Troy0408/Embedded-Course-Design/docs/嵌入式系统课程设计.md

# 2026嵌入式系统课程设计

## 时间安排

地点：理学馆210

### 集合与选题

时间：2026-06-29 9:00

- 宣布课程设计要求与考核标准
- 分组选题，确定题目（三选一），每组不超过3人

### 提交计划书

时间：2026-06-30 9:00

各组提交《项目计划书》（本阶段为小组任务，每组提交一份），内容包括：

- **工作计划**：从选题到验收的详细时间节点，明确各阶段里程碑
- **时间安排**：组内成员的可投入时间与分工协调计划
- **物料采购计划**：列出所需全部物料清单（型号、数量、单价、采购渠道），预估总成本
- **分工方案**：明确每位成员的具体职责（硬件设计、软件开发、测试调试、文档撰写等）

### 设计文档提交与汇报

时间：2026-07-02 9:00

各组提交《系统设计文档》并分组汇报（本阶段为小组任务，每组提交一份），内容包括：

- **物料到位情况**：已到货物料清单与实物核对情况，未到货物料的预计到位时间
- **系统方案设计**：系统总体架构、硬件框图、软件流程图
- **详细设计文档**：
  - 硬件部分：电路原理图、关键元件参数计算、PCB布局规划（如有）
  - 软件部分：模块划分、关键算法描述、外设配置方案、任务调度设计（FreeRTOS任务划分等）
- **进度汇报**：当前完成情况与后续工作计划

### 中期检查

时间：2026-07-06 15:00

- 物料完备性检查：核对所有物料是否到位
- 进度检查：硬件搭建情况、软件调试进度
- 问题排查：识别当前瓶颈，给出解决方案建议

各组提交《中期检查报告》（本阶段为小组任务，每组提交一份），内容包括：

- 物料到位总览：已到位、未到位的物料明细
- 当前完成进度：已完成工作、进行中工作、未开始工作
- 硬件调试情况：各模块测试结果、遇到的问题与解决措施
- 软件调试情况：各功能模块开发进度、已通过的测试用例
- 存在的问题与风险：技术难点、物料延期等风险及应对方案
- 后续工作计划：至验收前的详细计划与分工调整（如有）

### 第一次验收

时间：2026-07-09 9:00

- 分组演示系统功能，现场测试
- 教师提出问题与修改意见
- 提交阶段性成果（功能演示视频、测试数据记录）

### 第二次验收

时间：2026-07-10 9:00

- 根据第一次验收意见进行改进后再次验收
- 最终评定成绩

### 个人总结报告

提交截止：验收后一周内

每位同学独立提交个人总结报告（每人一份），使用 LaTeX 模板撰写（模板参见 `课程报告LaTex模板/`），报告应包含以下章节：

| 章节 | 内容要求 |
| ---- | ---- |
| 项目简介 | 项目背景、主要功能概述 |
| 项目设计目标 | 设计目标与预期成果 |
| 项目设计与实现 | 硬件设计（系统架构、模块选型、电路原理图）、软件设计（软件架构、主程序流程、关键代码、技术实现细节） |
| 功能展示 | 功能描述、演示结果、测试数据与截图 |
| 物料与成本 | 物料清单（名称、数量、单价、用途）、项目总成本、损耗与损坏记录 |
| 个人贡献 | 报告撰写分工、个人编码工作内容、硬件连接工作、资本投入、开发中遇到的问题及解决方案 |
| 项目成果与反思 | 成果展示、项目评估（成功之处与不足）、个人反思与改进方向 |
| 附录 | 设计图纸、完整代码清单、参考文献 |

#### 题目：基于STM32F103C8T6的智能手表设计

##### 介绍

智能手表项目是一个基于STM32F103C8T6的嵌入式系统，采用FreeRTOS实时操作系统实现多任务管理，集成OLED显示和陀螺仪姿态检测等功能。项目涵盖硬件电路设计、RTOS任务调度、I2C总线通信及低功耗电源管理，适合学习嵌入式系统综合开发。

##### 基本原理

**硬件架构**：采用STM32F103C8T6作为主控MCU，通过I2C总线连接OLED显示屏（1.3寸）及陀螺仪（MPU6050）。I2C总线只需SCL和SDA两根线即可实现多设备通信，布线简洁。时间基准利用SysTick定时器或通用定时器产生秒中断实现软件计时，无需额外RTC芯片。电源部分采用LDO低压差稳压芯片，通过Type-C接口为3.7V锂电池充电，并设计一键开机电路。

**FreeRTOS任务调度**：FreeRTOS是一个轻量级实时操作系统内核，支持抢占式和合作式两种任务调度方式。高优先级任务可抢占低优先级任务的CPU资源。任务状态包括运行态、就绪态、阻塞态和挂起态。系统的时钟节拍由SysTick滴答定时器提供，每次中断驱动OS的任务调度。

**任务间通信**：为防止多任务对共享资源的访问冲突，FreeRTOS提供信号量（二值信号量、计数信号量、互斥信号量）、消息队列和邮箱等通信机制，实现任务同步与数据传递。

**内存管理**：FreeRTOS提供多种内存分配策略，其中heap_4按物理地址排序管理空闲块，便于相邻空闲内存的合并，减少碎片。

##### 基本要求

- 完成智能手表硬件电路设计（MCU、OLED、陀螺仪、电源）
- 基于FreeRTOS实现多任务管理，完成时间显示与传感器数据读取
- 实现OLED界面显示，至少包含时间页面与传感器数据页面

##### 扩展要求

1. 增加旋转编码器，实现多级菜单的切换与选择
2. 增加蓝牙控制功能，实现与手机的数据同步，并设计蓝牙上位机
3. 完成PCB的设计，可使用最小系统板
4. 实现运动计步算法与运动数据记录功能

##### 考核要求

| 等级 | 评定标准 |
| ---- | ---- |
| 优秀 | 完成全部基本要求与扩展要求1、2，以及3或4（PCB设计与计步功能二选一）；PCB布局布线合理（选3时）；计步算法准确、数据记录完整（选4时）；FreeRTOS任务划分合理、无死锁；OLED多级菜单流畅，蓝牙同步稳定，上位机界面美观、功能完整；设计文档详实，答辩表述清晰。 |
| 良好 | 完成全部基本要求与扩展要求1、2；OLED多级菜单切换流畅；蓝牙同步与上位机功能正常；设计文档完整，答辩表述较清晰。 |
| 中等 | 完成全部基本要求与至少一项扩展要求；OLED可正常显示时间与传感器数据；设计文档基本完整，答辩能说明设计思路。 |
| 及格 | 完成基本要求；OLED可显示时间信息；设计文档包含关键内容，答辩能回答基本问题。 |

##### 设计步骤

1. **需求分析与方案设计**：明确智能手表的功能需求，确定硬件选型与软件架构，划分FreeRTOS任务。
2. **硬件电路设计**：设计STM32最小系统、OLED/MPU6050的I2C接口电路、LDO电源电路及一键开机电路。
3. **FreeRTOS移植与任务划分**：移植FreeRTOS到STM32F103C8T6，划分任务（UI显示任务、时间管理任务、传感器采集任务、蓝牙通信任务等），定义任务优先级与通信方式。
4. **外设驱动开发**：编写I2C驱动、OLED驱动、MPU6050驱动及软件计时模块（基于SysTick/定时器秒中断），完成数据读取与显示。
5. **系统集成与测试**：整合各模块，调试多任务运行，测试菜单切换、传感器数据更新、蓝牙通信等功能，分析并优化系统性能。

##### DEMO参考

参考DEMO所用器件：

| 器件 | 参数 |
| ---- | ---- |
| 主控芯片 | STM32F103C8T6 |
| 显示屏 | 1.3寸 OLED（I2C接口） |
| 陀螺仪 | MPU6050（I2C接口） |
| 电源芯片 | LDO低压差稳压芯片 |
| 电池 | 3.7V锂电池 |
| 供电接口 | Type-C |
