Troy0408/Embedded-Course-Design/SmartWatch_FreeRTOS/SmartWatch_FreeRTOS.ioc

Mcu.UserName=STM32F103C8Tx
PA13.Signal=SYS_JTMS-SWDIO
PA14.Signal=SYS_JTCK-SWCLK
PA2.Signal=USART2_TX
PA3.Signal=USART2_RX
PA6.GPIO_Label=ENCODER_A
PA6.Signal=GPIO_Input
PA7.GPIO_Label=ENCODER_B
PA7.Signal=GPIO_Input
PB1.GPIO_Label=BUTTON_OK
PB1.Signal=GPIO_Input
PB0.GPIO_Label=HC05_STATE
PB0.Signal=GPIO_Input
PB10.Signal=I2C2_SCL
PB11.Signal=I2C2_SDA
PB6.Signal=I2C1_SCL
PB7.Signal=I2C1_SDA
PD0-OSC_IN.Signal=RCC_OSC_IN
PD1-OSC_OUT.Signal=RCC_OSC_OUT
