Troy0408/Embedded-Course-Design/SmartWatch_FreeRTOS/Core/Src/main.c

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
/* Includes ------------------------------------------------------------------*/
#include "main.h"
#include "dma.h"
#include "i2c.h"
#include "usart.h"
#include "gpio.h"

/* USER CODE BEGIN Includes */
#include "oled.h"
#include "smartwatch_ui.h"
#include "mpu6050.h"
#include "usart.h"
#include "bluetooth.h"
#include "encoder.h"
#include "step_counter.h"
#include "app_freertos.h"
/* USER CODE END Includes */


/* USER CODE BEGIN PV */
SmartWatchData_t watch_data;
StepCounter_t step_counter;
/* USER CODE END PV */

void SystemClock_Config(void);
/* USER CODE BEGIN 0 */
static void UpdateMpuDiagnostics(SmartWatchData_t *data)
{
    data->mpu_ready_68 = MPU6050_IsReadyAt(0x68);
    data->mpu_ready_69 = MPU6050_IsReadyAt(0x69);
    data->mpu_whoami_68 = data->mpu_ready_68 ? MPU6050_ReadWhoAmIAt(0x68) : 0x00;
    data->mpu_whoami_69 = data->mpu_ready_69 ? MPU6050_ReadWhoAmIAt(0x69) : 0x00;
}

static void UpdateEncoderDiagnostics(SmartWatchData_t *data)
{
    EncoderDebug_t debug;
    Encoder_GetDebug(&debug);
    data->enc_a = debug.a;
    data->enc_b = debug.b;
    data->enc_cw = debug.cw_count;
    data->enc_ccw = debug.ccw_count;
    data->enc_press = debug.press_count;
    data->enc_transitions = debug.transition_count;
}

/* USER CODE END 0 */

/**
  * @brief  The application entry point.
  * @retval int
  */
int main(void)
{

  /* MCU Configuration--------------------------------------------------------*/

  /* Reset of all peripherals, Initializes the Flash interface and the Systick. */
  HAL_Init();

  /* Configure the system clock */
  SystemClock_Config();

  /* Initialize all configured peripherals */
  MX_GPIO_Init();
  MX_DMA_Init();
  MX_I2C1_Init();
  MX_I2C2_Init();
  MX_USART2_UART_Init();
  /* USER CODE BEGIN 2 */

  UI_InitData(&watch_data);

  /* Initialize OLED */
  OLED_Init();

  /* Initialize MPU6050 */
  UpdateMpuDiagnostics(&watch_data);
  watch_data.imu_status = (MPU6050_Init() == 0) ? 1 : 0;
  if (!watch_data.imu_status) {
      UpdateMpuDiagnostics(&watch_data);
  }

  /* Initialize Bluetooth */
  BT_Init();
  watch_data.bt_connected = 0;

  /* Initialize encoder and step counter */
  Encoder_Init();
  StepCounter_Init(&step_counter);
  UpdateEncoderDiagnostics(&watch_data);

  /* Show watch face first */
  watch_data.current_page = PAGE_WATCH_FACE;
  UI_DrawPage(watch_data.current_page, &watch_data);

  App_FreeRTOS_Start();

  /* USER CODE END 2 */

  /* Infinite loop */
  /* USER CODE BEGIN WHILE */
  while (1)
  {
    /* USER CODE END WHILE */

    /* USER CODE BEGIN 3 */
    HAL_Delay(1000);
  }
  /* USER CODE END 3 */
}

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
