Troy0408/Embedded-Course-Design/SmartWatch_FreeRTOS/Core/Inc/main.h

#define HC05_STATE_Pin GPIO_PIN_0
#define HC05_STATE_GPIO_Port GPIOB
#define BUTTON_OK_Pin GPIO_PIN_1
#define BUTTON_OK_GPIO_Port GPIOB
#define ENCODER_A_Pin GPIO_PIN_6
#define ENCODER_A_GPIO_Port GPIOA
#define ENCODER_B_Pin GPIO_PIN_7
#define ENCODER_B_GPIO_Port GPIOA
