Troy0408/Embedded-Course-Design/SmartWatch_FreeRTOS/Core/Src/oled.c

#include "oled.h"
#include "i2c.h"
#include <stdio.h>
#include <stdarg.h>
#include <string.h>

/* ==================== Framebuffer ==================== */
uint8_t OLED_Buffer[SSD1306_WIDTH * SSD1306_PAGES];

/* ==================== 6x8 Font (ASCII 0x20-0x7E, 95 chars, 6 bytes each) ==================== */
static const uint8_t Font6x8[96][6] = {
    {0x00,0x00,0x00,0x00,0x00,0x00}, /*   space */
    {0x00,0x00,0x5F,0x00,0x00,0x00}, /* ! */
    {0x00,0x07,0x00,0x07,0x00,0x00}, /* " */
    {0x14,0x7F,0x14,0x7F,0x14,0x00}, /* # */
    {0x24,0x2A,0x7F,0x2A,0x12,0x00}, /* $ */
    {0x23,0x13,0x08,0x64,0x62,0x00}, /* % */
    {0x36,0x49,0x55,0x22,0x50,0x00}, /* & */
    {0x00,0x05,0x03,0x00,0x00,0x00}, /* ' */
    {0x00,0x1C,0x22,0x41,0x00,0x00}, /* ( */
    {0x00,0x41,0x22,0x1C,0x00,0x00}, /* ) */
    {0x08,0x2A,0x1C,0x2A,0x08,0x00}, /* * */
    {0x08,0x08,0x3E,0x08,0x08,0x00}, /* + */
    {0x00,0x50,0x30,0x00,0x00,0x00}, /* , */
    {0x08,0x08,0x08,0x08,0x08,0x00}, /* - */
    {0x00,0x60,0x60,0x00,0x00,0x00}, /* . */
    {0x20,0x10,0x08,0x04,0x02,0x00}, /* / */
    {0x3E,0x51,0x49,0x45,0x3E,0x00}, /* 0 */
    {0x00,0x42,0x7F,0x40,0x00,0x00}, /* 1 */
    {0x42,0x61,0x51,0x49,0x46,0x00}, /* 2 */
    {0x21,0x41,0x45,0x4B,0x31,0x00}, /* 3 */
    {0x18,0x14,0x12,0x7F,0x10,0x00}, /* 4 */
    {0x27,0x45,0x45,0x45,0x39,0x00}, /* 5 */
    {0x3C,0x4A,0x49,0x49,0x30,0x00}, /* 6 */
    {0x01,0x71,0x09,0x05,0x03,0x00}, /* 7 */
    {0x36,0x49,0x49,0x49,0x36,0x00}, /* 8 */
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
     0x00,0x00,0x00,0x01,0x01,0x01,0x01,0x81,0xC1,0x61,0x3F,0x1F,0x00,0x00,0x00,0x00,
     0x00,0x00,0x00,0x20,0x61,0x63,0x63,0x63,0x63,0x32,0x1E,0x0F,0x00,0x00,0x00,0x00},
    /* : */
    {0x00,0x00,0x00,0x00,0x00,0x30,0x30,0x00,0x00,0x00,0x00,0x00,0x00,0x00,0x00,0x00,
     0x00,0x00,0x00,0x00,0x00,0x18,0x18,0x00,0x00,0x00,0x00,0x00,0x00,0x00,0x00,0x00,
     0x00,0x00,0x00,0x00,0x00,0x0C,0x0C,0x00,0x00,0x00,0x00,0x00,0x00,0x00,0x00,0x00},
};

/* ==================== Icon bitmaps ==================== */
/* Heart icon 10x10 */
const uint8_t IconHeart[20] = {
    0x1E,0x3F,0x7F,0xFE,0xFC,0xFC,0xFE,0x7F,0x3F,0x1E, /* upper 10 */
    0x00,0x00,0x00,0x00,0x00,0x00,0x00,0x00,0x00,0x00  /* lower (empty for page alignment) */
};
/* Battery body 12x6 (page 0) */
const uint8_t IconBattery[12] = {
    0xFE,0x82,0x82,0x82,0x82,0x82,0x82,0x82,0x82,0x82,0xFE,0x38
};
/* Bluetooth icon 8x8 */
const uint8_t IconBT[8] = {
    0x10,0x18,0x14,0x32,0x7E,0x32,0x14,0x18
};

/* ==================== I2C Helper ==================== */

static void SSD1306_WriteCommand(uint8_t cmd) {
    HAL_I2C_Mem_Write(&hi2c1, SSD1306_ADDR << 1, 0x00, I2C_MEMADD_SIZE_8BIT, &cmd, 1, 100);
}

static void SSD1306_WriteCommands(const uint8_t *cmds, uint8_t len) {
    HAL_I2C_Mem_Write(&hi2c1, SSD1306_ADDR << 1, 0x00, I2C_MEMADD_SIZE_8BIT, (uint8_t *)cmds, len, 100);
}

static void SSD1306_WriteData(const uint8_t *data, uint16_t len) {
    HAL_I2C_Mem_Write(&hi2c1, SSD1306_ADDR << 1, 0x40, I2C_MEMADD_SIZE_8BIT, (uint8_t *)data, len, 200);
}

/* ==================== Initialization ==================== */

void OLED_Init(void) {
    /* Wait for SSD1306 power-up */
    HAL_Delay(100);

    /* Init sequence */
    uint8_t init[] = {
        0xAE,       /* Display OFF */
        0x20, 0x00, /* Horizontal addressing mode */
        0x40,       /* Display start line = 0 */
        0xA1,       /* Segment remap: col 127 = SEG0 */
        0xC8,       /* COM scan direction: COM[N-1] to COM0 */
        0xA8, 0x3F, /* Multiplex ratio: 63 (64 rows) */
        0xD3, 0x00, /* Display offset: 0 */
        0xD5, 0x80, /* Clock divide / oscillator frequency */
        0xD9, 0xF1, /* Pre-charge period */
        0xDA, 0x12, /* COM pins hardware config: alternative */
        0xDB, 0x40, /* VCOMH deselect level */
        0x81, 0xCF, /* Contrast: 207 */
        0x8D, 0x14, /* Charge pump enable */
        0xA4,       /* Entire display ON: follows RAM */
        0xA6,       /* Normal display (not inverted) */
        0x2E,       /* Deactivate scroll */
        0xAF        /* Display ON */
    };
    SSD1306_WriteCommands(init, sizeof(init));
    OLED_Clear();
}

void OLED_SetContrast(uint8_t contrast) {
    SSD1306_WriteCommand(0x81);
    SSD1306_WriteCommand(contrast);
}

void OLED_DisplayOn(void)  { SSD1306_WriteCommand(0xAF); }
void OLED_DisplayOff(void) { SSD1306_WriteCommand(0xAE); }
void OLED_InvertDisplay(uint8_t invert) {
    SSD1306_WriteCommand(invert ? 0xA7 : 0xA6);
}

/* ==================== Framebuffer Operations ==================== */

void OLED_Clear(void) {
    memset(OLED_Buffer, 0x00, sizeof(OLED_Buffer));
    OLED_Update();
}

void OLED_ClearBuffer(void) {
    memset(OLED_Buffer, 0x00, sizeof(OLED_Buffer));
}

void OLED_Update(void) {
    /* Page addressing mode for reliable transmission */
    for (uint8_t page = 0; page < SSD1306_PAGES; page++) {
        uint8_t cmds[] = {
            0xB0 | page,   /* Set page address */
            0x00,          /* Set lower column start */
            0x10           /* Set higher column start */
        };
        SSD1306_WriteCommands(cmds, 3);
        SSD1306_WriteData(&OLED_Buffer[page * SSD1306_WIDTH], SSD1306_WIDTH);
    }
}

void OLED_UpdateArea(uint8_t start_page, uint8_t end_page) {
    for (uint8_t page = start_page; page <= end_page; page++) {
        uint8_t cmds[] = { 0xB0 | page, 0x00, 0x10 };
        SSD1306_WriteCommands(cmds, 3);
        SSD1306_WriteData(&OLED_Buffer[page * SSD1306_WIDTH], SSD1306_WIDTH);
    }
}

/* ==================== Drawing Primitives ==================== */

void OLED_SetPixel(uint8_t x, uint8_t y, uint8_t color) {
    if (x >= SSD1306_WIDTH || y >= SSD1306_HEIGHT) return;
    if (color)
        OLED_Buffer[x + (y / 8) * SSD1306_WIDTH] |= (1 << (y & 7));
    else
        OLED_Buffer[x + (y / 8) * SSD1306_WIDTH] &= ~(1 << (y & 7));
}

void OLED_DrawHLine(uint8_t x, uint8_t y, uint8_t w) {
    for (uint8_t i = 0; i < w; i++) OLED_SetPixel(x + i, y, 1);
}

void OLED_DrawVLine(uint8_t x, uint8_t y, uint8_t h) {
    for (uint8_t i = 0; i < h; i++) OLED_SetPixel(x, y + i, 1);
}

void OLED_DrawLine(uint8_t x0, uint8_t y0, uint8_t x1, uint8_t y1) {
    int16_t dx = (int16_t)x1 - x0;
    int16_t dy = (int16_t)y1 - y0;
    int16_t sx = dx > 0 ? 1 : -1;
    int16_t sy = dy > 0 ? 1 : -1;
    dx = dx > 0 ? dx : -dx;
    dy = dy > 0 ? dy : -dy;
    int16_t err = dx - dy;

    while (1) {
        OLED_SetPixel(x0, y0, 1);
        if (x0 == x1 && y0 == y1) break;
        int16_t e2 = 2 * err;
        if (e2 > -dy) { err -= dy; x0 += sx; }
        if (e2 < dx)  { err += dx; y0 += sy; }
    }
}

void OLED_DrawRect(uint8_t x, uint8_t y, uint8_t w, uint8_t h) {
    OLED_DrawHLine(x, y, w);
    OLED_DrawHLine(x, y + h - 1, w);
    OLED_DrawVLine(x, y, h);
    OLED_DrawVLine(x + w - 1, y, h);
}

void OLED_DrawFilledRect(uint8_t x, uint8_t y, uint8_t w, uint8_t h) {
    for (uint8_t i = 0; i < h; i++)
        OLED_DrawHLine(x, y + i, w);
}

void OLED_DrawCircle(uint8_t cx, uint8_t cy, uint8_t r) {
    int16_t x = 0, y = r;
    int16_t d = 3 - 2 * r;
    while (y >= x) {
        OLED_SetPixel(cx + x, cy + y, 1);
        OLED_SetPixel(cx - x, cy + y, 1);
        OLED_SetPixel(cx + x, cy - y, 1);
        OLED_SetPixel(cx - x, cy - y, 1);
        OLED_SetPixel(cx + y, cy + x, 1);
        OLED_SetPixel(cx - y, cy + x, 1);
        OLED_SetPixel(cx + y, cy - x, 1);
        OLED_SetPixel(cx - y, cy - x, 1);
        x++;
        if (d > 0) { y--; d += 4 * (x - y) + 10; }
        else        { d += 4 * x + 6; }
    }
}

void OLED_DrawFilledCircle(uint8_t cx, uint8_t cy, uint8_t r) {
    int16_t x = 0, y = r;
    int16_t d = 3 - 2 * r;
    while (y >= x) {
        OLED_DrawHLine(cx - x, cy - y, 2 * x + 1);
        OLED_DrawHLine(cx - x, cy + y, 2 * x + 1);
        OLED_DrawHLine(cx - y, cy - x, 2 * y + 1);
        OLED_DrawHLine(cx - y, cy + x, 2 * y + 1);
        x++;
        if (d > 0) { y--; d += 4 * (x - y) + 10; }
        else        { d += 4 * x + 6; }
    }
}

void OLED_DrawBitmap(uint8_t x, uint8_t y, const uint8_t *bitmap, uint8_t w, uint8_t h) {
    for (uint8_t j = 0; j < h; j++) {
        for (uint8_t i = 0; i < w; i++) {
            if (bitmap[i + (j / 8) * w] & (1 << (j & 7)))
                OLED_SetPixel(x + i, y + j, 1);
        }
    }
}

/* ==================== Text Rendering (6x8 font) ==================== */

void OLED_DrawChar6x8(uint8_t x, uint8_t page, char c) {
    if (page >= SSD1306_PAGES) return;
    if (c < 0x20 || c > 0x7E) c = ' ';

    const uint8_t *glyph = Font6x8[(uint8_t)(c - 0x20)];
    for (uint8_t col = 0; col < 6; col++) {
        if (x + col < SSD1306_WIDTH)
            OLED_Buffer[x + col + page * SSD1306_WIDTH] = glyph[col];
    }
}

void OLED_DrawString6x8(uint8_t x, uint8_t page, const char *str) {
    while (*str) {
        OLED_DrawChar6x8(x, page, *str);
        x += 6;
        if (x + 6 > SSD1306_WIDTH) break;
        str++;
    }
}

/* ==================== Text Rendering (8x16 font) ==================== */

static uint8_t _char_index_8x16(char c) {
    if (c >= '0' && c <= '9') return c - '0';
    if (c == ':') return 10;
    if (c == '.') return 11;
    if (c == '-') return 12;
    if (c == '/') return 13;
    if (c == ' ') return 14;
    if (c >= 'A' && c <= 'Z') return 15 + (c - 'A');
    if (c >= 'a' && c <= 'z') return 15 + (c - 'a');  /* lowercase mapped to uppercase */
    return 14; /* default: space */
}

void OLED_DrawChar8x16(uint8_t x, uint8_t page, char c) {
    if (page + 1 >= SSD1306_PAGES) return;
    if (x + 8 > SSD1306_WIDTH) return;

    uint8_t idx = _char_index_8x16(c);
    const uint8_t *glyph = Font8x16[idx];

    for (uint8_t col = 0; col < 8; col++) {
        OLED_Buffer[x + col + page * SSD1306_WIDTH] = glyph[col];
        OLED_Buffer[x + col + (page + 1) * SSD1306_WIDTH] = glyph[col + 8];
    }
}

void OLED_DrawString8x16(uint8_t x, uint8_t page, const char *str) {
    while (*str) {
        OLED_DrawChar8x16(x, page, *str);
        x += 8;
        if (x + 8 > SSD1306_WIDTH) break;
        str++;
    }
}

/* ==================== Large Number (16x24) Rendering ==================== */

static void OLED_DrawSevenSegment(uint8_t x, uint8_t y, uint8_t segment)
{
    switch (segment) {
        case 0: OLED_DrawFilledRect(x + 3,  y,      10, 3); break; /* A */
        case 1: OLED_DrawFilledRect(x + 13, y + 3,   3, 8); break; /* B */
        case 2: OLED_DrawFilledRect(x + 13, y + 13,  3, 8); break; /* C */
        case 3: OLED_DrawFilledRect(x + 3,  y + 21, 10, 3); break; /* D */
        case 4: OLED_DrawFilledRect(x,      y + 13,  3, 8); break; /* E */
        case 5: OLED_DrawFilledRect(x,      y + 3,   3, 8); break; /* F */
        case 6: OLED_DrawFilledRect(x + 3,  y + 10, 10, 3); break; /* G */
        default: break;
    }
}

void OLED_DrawDigit16x24(uint8_t x, uint8_t y, uint8_t digit) {
    static const uint8_t segment_map[10] = {
        0x3F, /* 0: A B C D E F */
        0x06, /* 1: B C */
        0x5B, /* 2: A B D E G */
        0x4F, /* 3: A B C D G */
        0x66, /* 4: B C F G */
        0x6D, /* 5: A C D F G */
        0x7D, /* 6: A C D E F G */
        0x07, /* 7: A B C */
        0x7F, /* 8: A B C D E F G */
        0x6F  /* 9: A B C D F G */
    };

    if (digit > 9) return;
    if (x + 16 > SSD1306_WIDTH || y + 24 > SSD1306_HEIGHT) return;

    uint8_t mask = segment_map[digit];
    for (uint8_t segment = 0; segment < 7; segment++) {
        if ((mask & (1U << segment)) != 0U) {
            OLED_DrawSevenSegment(x, y, segment);
        }
    }
}

void OLED_DrawColon16x24(uint8_t x, uint8_t y) {
    if (x + 16 > SSD1306_WIDTH || y + 24 > SSD1306_HEIGHT) return;

    OLED_DrawFilledRect(x + 6, y + 6, 3, 3);
    OLED_DrawFilledRect(x + 6, y + 15, 3, 3);
}

void OLED_DrawTime16x24(uint8_t x, uint8_t y, uint8_t hour, uint8_t minute) {
    OLED_DrawDigit16x24(x,       y, hour / 10);
    OLED_DrawDigit16x24(x + 18,  y, hour % 10);
    OLED_DrawColon16x24(x + 36,  y);
    OLED_DrawDigit16x24(x + 54,  y, minute / 10);
    OLED_DrawDigit16x24(x + 72,  y, minute % 10);
}

/* ==================== printf-style output ==================== */

void OLED_Printf6x8(uint8_t x, uint8_t page, const char *fmt, ...) {
    char buf[32];
    va_list args;
    va_start(args, fmt);
    vsnprintf(buf, sizeof(buf), fmt, args);
    va_end(args);
    OLED_DrawString6x8(x, page, buf);
}
