Troy0408/Embedded-Course-Design/(commit log)

2026-07-01 clone了课程报告LaTex模板
2026-07-01 提交设计文档
2026-07-01 其实就是README
2026-07-01 课程设计要求
2026-07-01 clone了SmartWatch
2026-07-05 fix: harden bluetooth protocol state handling
    [bluetooth.c]
2026-07-05 fix: define bluetooth ack and rx edge handling
    [bluetooth.c]
2026-07-05 fix: serialize bluetooth ack and tx state
    [bluetooth.c]
2026-07-05 fix: tighten bluetooth task scheduling
    [app_freertos.c]
2026-07-05 fix: keep bluetooth socket io off ui thread
2026-07-05 fix: refresh android bluetooth state
    [MainActivity.java]
2026-07-05 docs: update bluetooth uart baud to 9600
2026-07-06 上传可验收版本
2026-07-06 保存成品
2026-07-08 完成课程报告
2026-07-08 调整README内容
2026-07-13 规范命名格式
