Troy0408/Embedded-Course-Design/(notices)

Notices in the files:
SmartWatch_FreeRTOS/Core/Src/main.c:
Copyright (c) 2026 STMicroelectronics.
All rights reserved.
This software is licensed under terms that can be found in the LICENSE file
